mleo22d/knee-prosthesis-designer/(list of files, cad)

Other CAD files:
cad/bar_ab.ipt
cad/bar_bc.ipt
cad/bar_dc.ipt
cad/base_ad.ipt
cad/knee_prosthesis_assembly.iam
results/knee_gui_E50_M50_C50/bar_ab.ipt
results/knee_gui_E50_M50_C50/bar_bc.ipt
results/knee_gui_E50_M50_C50/bar_dc.ipt
results/knee_gui_E50_M50_C50/base_ad.ipt
results/knee_gui_E50_M50_C50/knee_gui_E50_M50_C50.iam
