mleo22d/knee-prosthesis-designer/drawings/eslabonFrontal.pdf

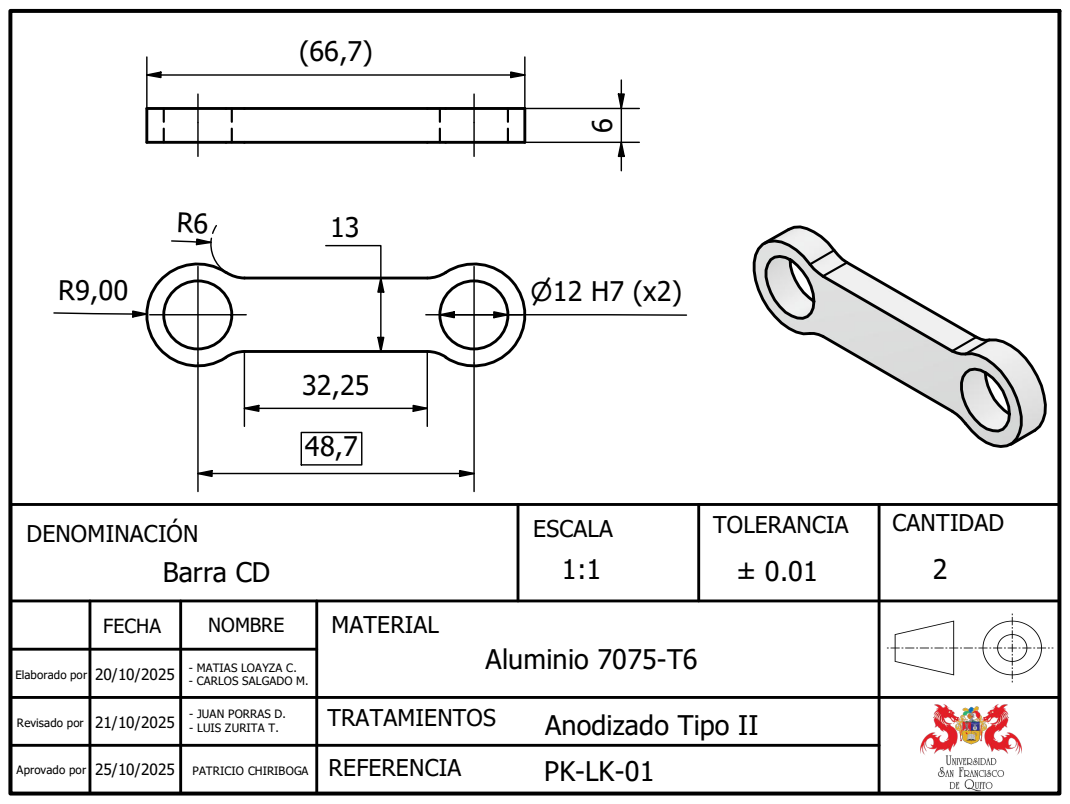
[picture p8: page 1]

Barra CD | ESCALA 1:1 | TOLERANCIA DENOMINACIÓN ± 0.01 | CANTIDAD 2

FECHA | NOMBRE | MATERIAL Aluminio 7075-T6 20/10/2025

Elaborado por | | - MATIAS LOAYZA C. - CARLOS SALGADO M.

Revisado por | 21/10/2025 | - JUAN PORRAS D. - LUIS ZURITA T. | TRATAMIENTOS Anodizado Tipo II

Aprovado por | 25/10/2025 | PATRICIO CHIRIBOGA | REFERENCIA PK-LK-01
