mleo22d/knee-prosthesis-designer/drawings/bujes.pdf

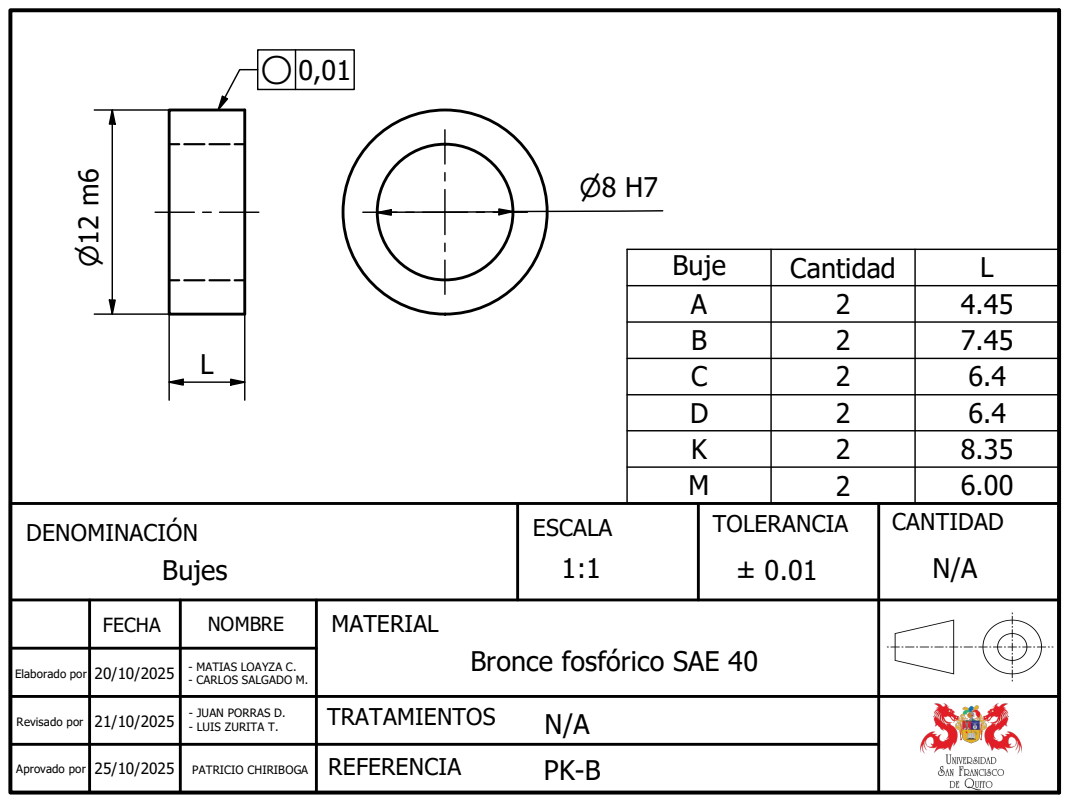
[picture p9: page 1]

Buje | Cantidad | L
A | 2 | 4.45
B | 2 | 7.45
C | 2 | 6.4
D | 2 | 6.4
K | 2 | 8.35
M | 2 | 6.00

Bujes | ESCALA 1:1 | TOLERANCIA DENOMINACIÓN ± 0.01 | CANTIDAD N/A

FECHA | NOMBRE | MATERIAL Bronce fosfórico SAE 40 20/10/2025

Elaborado por | | - MATIAS LOAYZA C. - CARLOS SALGADO M.

Revisado por | 21/10/2025 | - JUAN PORRAS D. - LUIS ZURITA T. | TRATAMIENTOS N/A

Aprovado por | 25/10/2025 | PATRICIO CHIRIBOGA | REFERENCIA PK-B
