mleo22d/knee-prosthesis-designer/drawings/ejes.pdf

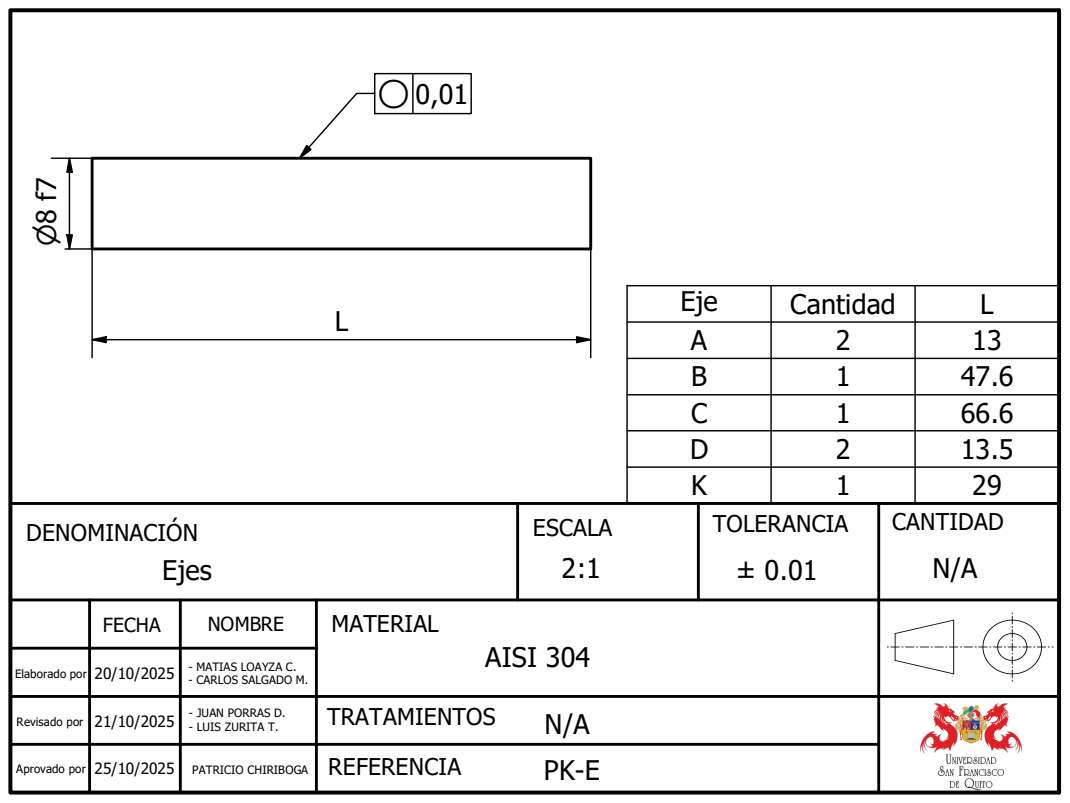
[picture p10: page 1]

Eje | Cantidad | L
A | 2 | 13
B | 1 | 47.6
C | 1 | 66.6
D | 2 | 13.5
K | 1 | 29

Ejes | ESCALA 2:1 | TOLERANCIA DENOMINACIÓN ± 0.01 | CANTIDAD N/A

FECHA | NOMBRE | MATERIAL AISI 304

Elaborado por | 20/10/2025 | - MATIAS LOAYZA C. - CARLOS SALGADO M.

Revisado por | 21/10/2025 | - JUAN PORRAS D. - LUIS ZURITA T. | TRATAMIENTOS N/A

Aprovado por | 25/10/2025 | PATRICIO CHIRIBOGA | REFERENCIA PK-E
