mleo22d/knee-prosthesis-designer/drawings/plano_conjunto.pdf

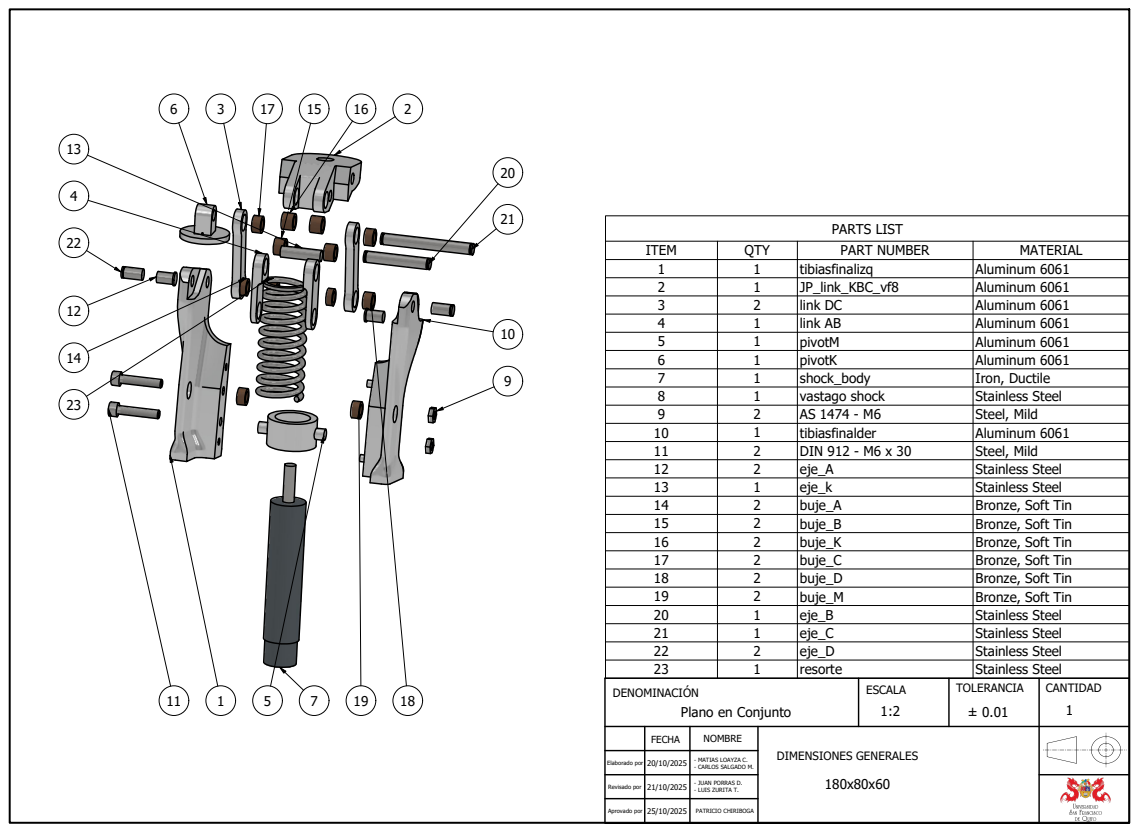
[picture p11: page 1]

I T E M | Q TY | P A RT N U M B E R | M A T E R I A L
1 | 1 | t i b i a s f i n ali z q | Alu m i n u m 6 0 6 1
2 | 1 | J P _li n k_ K B C _ v f 8 | Alu m i n u m 6 0 6 1
3 | 2 | li n k D C | Alu m i n u m 6 0 6 1
4 | 1 | li n k A B | Alu m i n u m 6 0 6 1
5 | 1 | p i v o t M | Alu m i n u m 6 0 6 1
6 | 1 | p i v o t K | Alu m i n u m 6 0 6 1
7 | 1 | s h o c k_ b o d y | I r o n , D u c t ile
8 | 1 | v a s t a g o s h o c k | S t a i nle s s S t e
2 1 | AS 1474 - M6 tibiasfinalder | Aluminum 606 Steel, Mild 10 el 9

1 1 | 2 | D I N 9 1 2 -M 6 x 3 0 | S t e el, M ild
1 2 | 2 | ej e _A | S t a i nle s s S t e
1 2 | eje_k buje_A | Stainless Steel 14 Bronze, Soft T el 13

1 5 | 2 | b u j e _ B | B r o n z e , S o ft T i n
1 6 | 2 | b u j e _ K | B r o n z e , S o ft T i n
1 7 | 2 | b u j e _ C | B r o n z e , S o ft T i n
1 8 | 2 | b u j e _ D | B r o n z e , S o ft T i n
1 9 | 2 | b u j e _ M | B r o n z e , S o ft T i n
2 0 | 1 | ej e _ B | S t a i nle s s S t e
1 2 1 | eje_C eje_D resorte | Stainless Steel 22 Stainless Steel 23 Stainless Steel TOLERANCIA el 21

5Pla F E C H A | N O M B R E | D I M E N S I O N E S G E N E RA L E S 1 8 0 x 8 0 x 6 0

Ela b o r a d o p o r | 2 0 / 1 0 / 2 0 2 5 | -M AT I A S L O A Y Z A C . -C A R L O S S A L G A D O M .
