mleo22d/knee-prosthesis-designer/(commit log)

2026-11-09 Código de la herramienta, CAD paramétrico, scripts de MATLAB, planos y README
    [bar_ab.ipt, bar_bc.ipt, bar_dc.ipt, base_ad.ipt, knee_gui_E50_M50_C50.iam, knee_prosthesis_assembly.iam]
2026-11-09 README: galería de imágenes del proyecto y enlace a la tesis
2026-11-09 README: interfaz gráfica y diseños generados para distintos parámetros clínicos
